winneymj/nrf52832_smartw/nrf.step

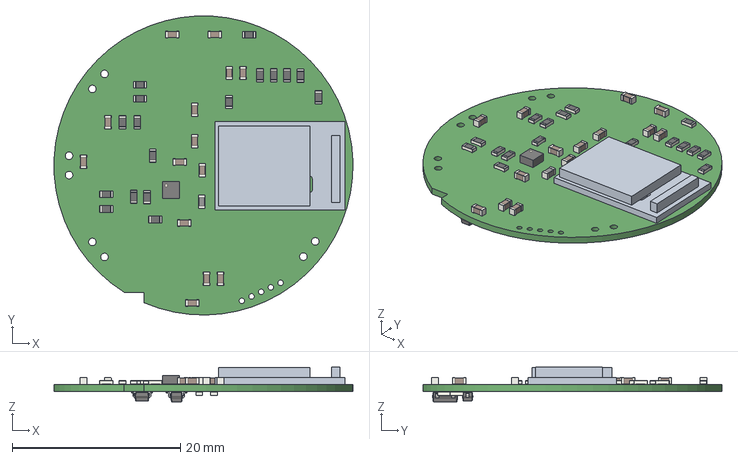
[picture p1: CAD file, 2021-01-30]
nrf.step
35.6 x 35.6 x 4.15 mm
