winneymj/nrf52832_smartw/nrf.kicad_pcb

## KiCad design nrf.kicad_pcb (2021-01-30)

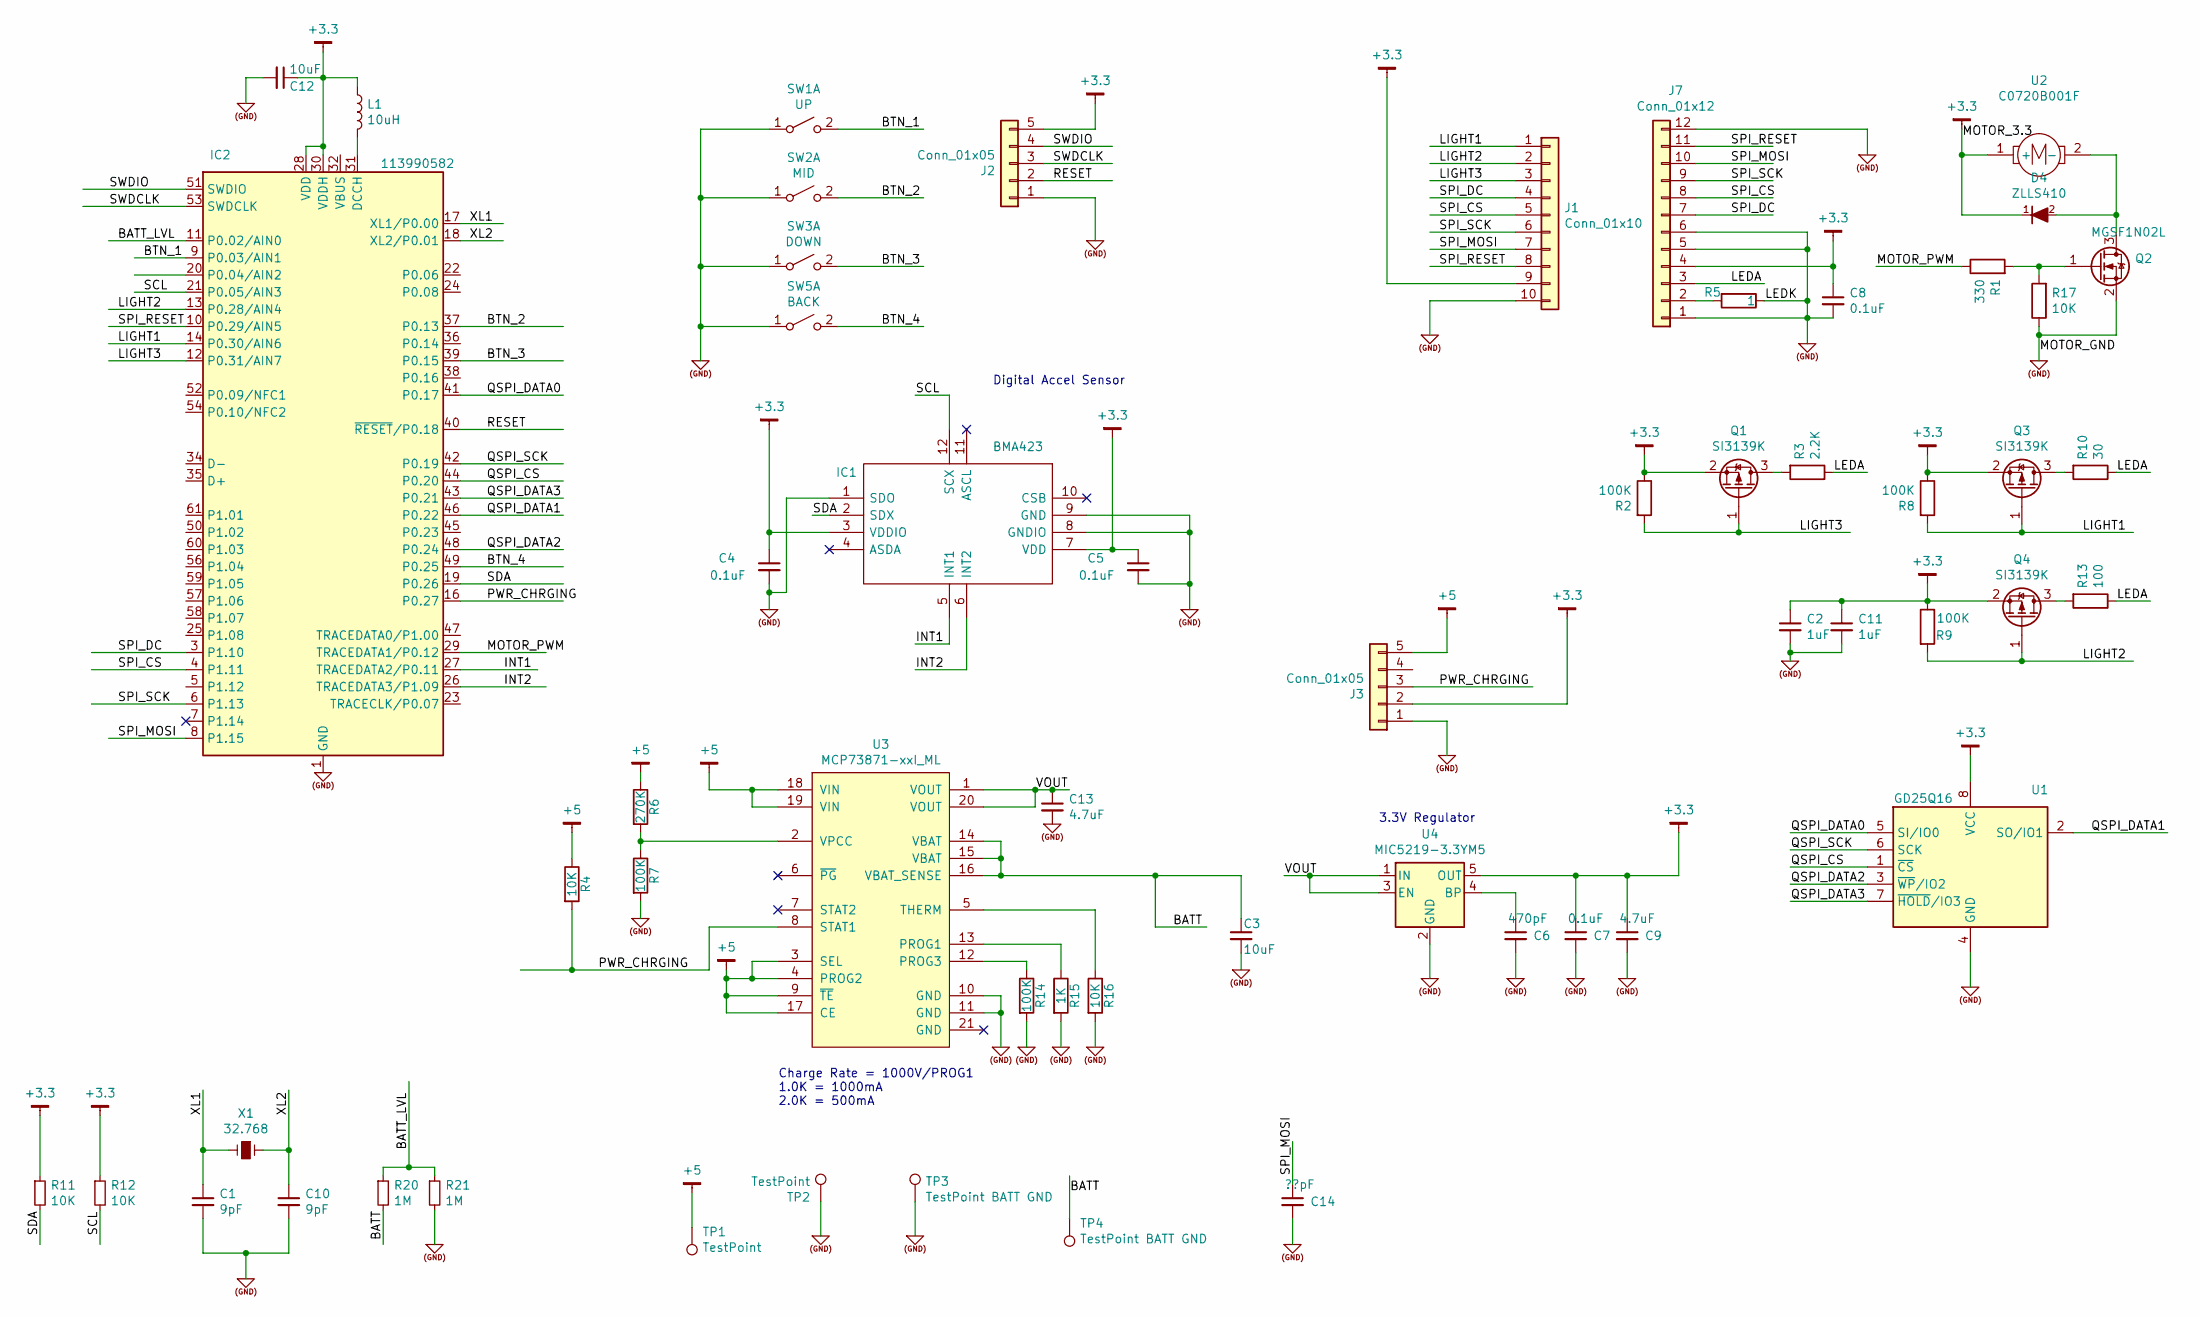
[picture p2: schematic nrf.sch]

Parts:
C1, C10: 9pF; C_0603_1608Metric_Pad1.08x0.95mm_HandSolder
C2, C11: 1uF; C_0603_1608Metric_Pad1.08x0.95mm_HandSolder
C3, C12: 10uF; C_0603_1608Metric_Pad1.08x0.95mm_HandSolder
C4, C5, C7, C8: 0.1uF; C_0603_1608Metric_Pad1.08x0.95mm_HandSolder
C6: 470pF; C_0603_1608Metric_Pad1.08x0.95mm_HandSolder
C9, C13: 4.7uF; C_0603_1608Metric_Pad1.08x0.95mm_HandSolder
C14: ??pF; C_0603_1608Metric_Pad1.08x0.95mm_HandSolder
D4: ZLLS410; D_SOD-323_HandSoldering
IC1: BMA423; LGA-12_2x2mm_P0.5mm_small_pad; Mouser Part Number 262-BMA423
IC2: 113990582; Raytac_MDBT50Q; Mouser Part Number 713-113990582
J1: Conn_01x10; Pin_Header_Straight_1x10_Pitch2.54mm
J2: Conn_01x05; Pin_Header_Straight_1x05_Pitch1.27mm
J3: Conn_01x05; Pin_Header_Straight_1x05_Pitch2.54mm
J7: Conn_01x12; FPC_12x0.7mm
L1: 10uH; L_0603_1608Metric_Pad1.05x0.95mm_HandSolder
Q1, Q3, Q4: SI3139K; SOT-723
Q2: MGSF1N02L; SOT-23
R1: 330; R_0603_1608Metric_Pad0.98x0.95mm_HandSolder
R2, R7, R8, R9, R14: 100K; R_0603_1608Metric_Pad0.98x0.95mm_HandSolder
R3: 2.2K; R_0603_1608Metric_Pad0.98x0.95mm_HandSolder
R4, R11, R12, R16, R17: 10K; R_0603_1608Metric_Pad0.98x0.95mm_HandSolder
R5: 1; R_0603_1608Metric_Pad0.98x0.95mm_HandSolder
R6: 270K; R_0603_1608Metric_Pad0.98x0.95mm_HandSolder
R10: 30; R_0603_1608Metric_Pad0.98x0.95mm_HandSolder
R13: 100; R_0603_1608Metric_Pad0.98x0.95mm_HandSolder
R15: 1K; R_0603_1608Metric_Pad0.98x0.95mm_HandSolder
R20, R21: 1M; R_0603_1608Metric_Pad0.98x0.95mm_HandSolder
SW1: UP; Tact_SW_3x6x3.5
SW2: MID; Tact_SW_3x6x3.5
SW3: DOWN; Tact_SW_3x6x3.5
SW5: BACK; Tact_SW_3x6x3.5
TP1, TP2: TestPoint; TestPoint_Pad_D1.5mm
TP3, TP4: TestPoint BATT GND; TestPoint_Pad_2.0x2.0mm
U1: GD25Q16; USON8-4x3
U2: C0720B001F; VIBRATION MOTOR COIN 3V FLEX - C0720B001F
U3: MCP73871-xxI_ML; QFN-20-1EP_4x4mm_Pitch0.5mm; MPN MCP73871-{output}I/ML
U4: MIC5219-3.3YM5; SOT-23-5
X1: 32.768; Crystal_SMD_EuroQuartz_EQ161-2pin_3.2x1.5mm_HandSoldering

Connections:
(GND): C1.2, C2.2, C3.2, C4.2, C5.2, C6.2, C7.2, C8.2, C9.2, C10.2, C11.2, C12.2, C13.2, C14.2, IC1.1 (SDO), IC1.8 (GNDIO), IC1.9 (GND), IC2.1 (GND), IC2.2 (GND), IC2.15 (GND), IC2.33 (GND), IC2.55 (GND), J1.10, J2.1, J3.1, J7.1, J7.5, J7.6, J7.12, Q2.2 (S), R5.1, R7.2, R14.2, R15.2, R16.2, R17.1, R21.2, SW1.1 (A), SW2.1 (A), SW3.1 (A), SW5.1 (A), TP2.1, TP3.1, U1.4 (GND), U3.10 (GND), U3.11 (GND), U4.2 (GND)
+3.3: C2.1, C4.1, C5.1, C7.1, C8.1, C9.1, C11.1, C12.1, D4.1 (K), IC1.3 (VDDIO), IC1.7 (VDD), IC2.28 (VDD), IC2.30 (VDDH), J1.9, J2.5, J3.2, J7.4, L1.1, Q1.2 (S), Q3.2 (S), Q4.2 (S), R2.1, R8.1, R9.1, R11.1, R12.1, U1.8 (VCC), U2.1 (+), U4.5 (OUT)
+5: J3.5, R4.1, R6.1, TP1.1, U3.3 (SEL), U3.4 (PROG2), U3.9 (~TE), U3.17 (CE), U3.18 (VIN), U3.19 (VIN)
/BATT: C3.1, R20.2, TP4.1, U3.14 (VBAT), U3.15 (VBAT), U3.16 (VBAT_SENSE)
/BATT_LVL: IC2.11 (P0.02/AIN0), R20.1, R21.1
/BTN_1: IC2.9 (P0.03/AIN1), SW1.2 (B)
/BTN_2: IC2.37 (P0.13), SW2.2 (B)
/BTN_3: IC2.39 (P0.15), SW3.2 (B)
/BTN_4: IC2.49 (P0.25), SW5.2 (B)
/INT1: IC1.5 (INT1), IC2.27 (TRACEDATA2/P0.11)
/INT2: IC1.6 (INT2), IC2.26 (TRACEDATA3/P1.09)
/LEDA: J7.3, R3.1, R10.1, R13.1
/LIGHT1: IC2.14 (P0.30/AIN6), J1.1, Q3.1 (G), R8.2
/LIGHT2: IC2.13 (P0.28/AIN4), J1.2, Q4.1 (G), R9.2
/LIGHT3: IC2.12 (P0.31/AIN7), J1.3, Q1.1 (G), R2.2
/MOTOR_PWM: IC2.29 (TRACEDATA1/P0.12), R1.1
/PWR_CHRGING: IC2.16 (P0.27), J3.3, R4.2, U3.8 (STAT1)
/QSPI_CS: IC2.44 (P0.20), U1.1 (~CS)
/QSPI_DATA0: IC2.41 (P0.17), U1.5 (SI/IO0)
/QSPI_DATA1: IC2.46 (P0.22), U1.2 (SO/IO1)
/QSPI_DATA2: IC2.48 (P0.24), U1.3 (~WP~/IO2)
/QSPI_DATA3: IC2.43 (P0.21), U1.7 (~HOLD~/IO3)
/QSPI_SCK: IC2.42 (P0.19), U1.6 (SCK)
/RESET: IC2.40 (~RESET~/P0.18), J2.2
/SCL: IC1.12 (SCX), IC2.21 (P0.05/AIN3), R12.2
/SDA: IC1.2 (SDX), IC2.19 (P0.26), R11.2
/SPI_CS: IC2.4 (P1.11), J1.5, J7.8
/SPI_DC: IC2.3 (P1.10), J1.4, J7.7
/SPI_MOSI: C14.1, IC2.8 (P1.15), J1.7, J7.10
/SPI_RESET: IC2.10 (P0.29/AIN5), J1.8, J7.11
/SPI_SCK: IC2.6 (P1.13), J1.6, J7.9
/SWDCLK: IC2.53 (SWDCLK), J2.3
/SWDIO: IC2.51 (SWDIO), J2.4
/VOUT: C13.1, U3.1 (VOUT), U3.20 (VOUT), U4.1 (IN), U4.3 (EN)
/XL1: C1.1, IC2.17 (XL1/P0.00), X1.2
/XL2: C10.1, IC2.18 (XL2/P0.01), X1.1
unnamed: C6.1, U4.4 (BP)
unnamed: D4.2 (A), Q2.3 (D), U2.2 (-)
unnamed: IC2.31 (DCCH), L1.2
unnamed: J7.2, R5.2
unnamed: Q1.3 (D), R3.2
unnamed: Q2.1 (G), R1.2, R17.2
unnamed: Q3.3 (D), R10.2
unnamed: Q4.3 (D), R13.2
unnamed: R6.2, R7.1, U3.2 (VPCC)
unnamed: R14.1, U3.12 (PROG3)
unnamed: R15.1, U3.13 (PROG1)
unnamed: R16.1, U3.5 (THERM)

Notes on the sheet:
Charge Rate = 1000V/PROG1 1.0K = 1000mA 2.0K = 500mA
3.3V Regulator
Digital Accel Sensor

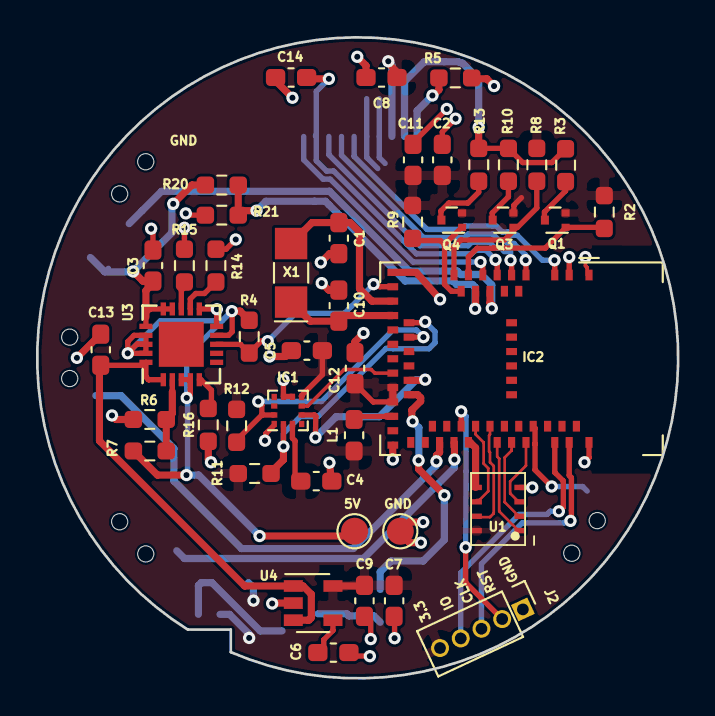
[picture p3: board nrf.kicad_pcb from above]

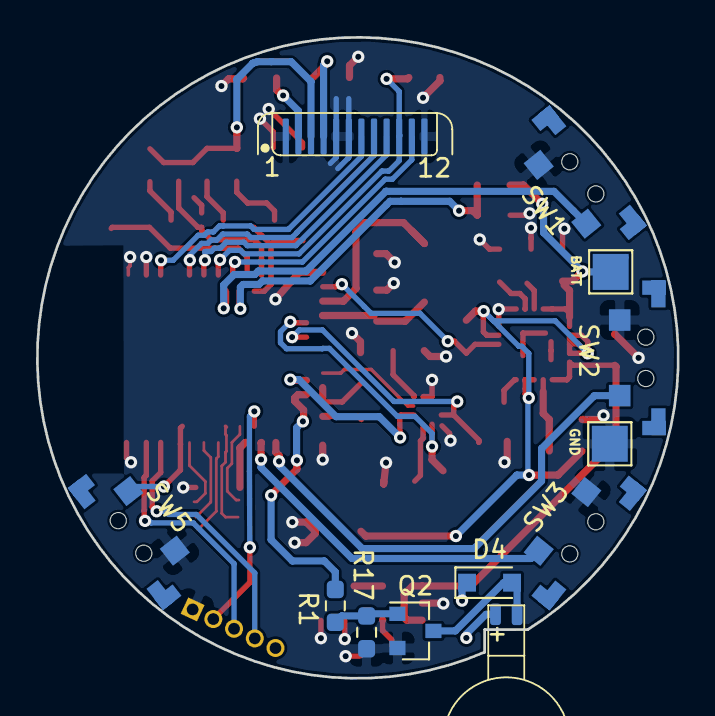
[picture p4: board nrf.kicad_pcb from below]

Board: 2 copper layers, 35.6 x 35.6 mm, 56 parts (12 on the bottom side), 48 nets.
