winneymj/nrf52832_smartw/240x240_display.kicad_pcb

## KiCad design 240x240_display.kicad_pcb (2020-10-25)

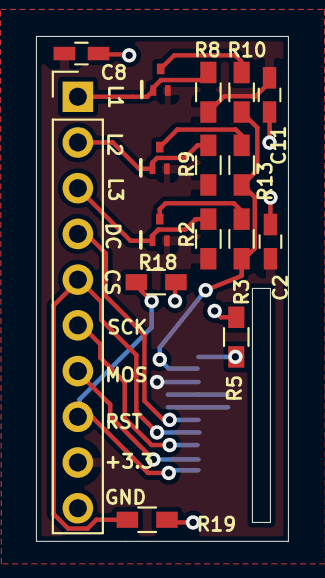
[picture p5: board 240x240_display.kicad_pcb from above]

Board: 2 copper layers, 14.0 x 28.0 mm, 17 parts (1 on the bottom side), 15 nets.

Parts:
C2, C11: 1uF; C_0603_HandSoldering
C8: 0.1uF; C_0603_HandSoldering
J1: Conn_01x10; Pin_Header_Straight_1x10_Pitch2.54mm
J7: Conn_01x12; FPC_12x0.7mm
Q1, Q3, Q4: SI3139K; SOT-723_Handsoldering
R2, R8, R9: 100K; R_0603_HandSoldering
R3: 2.2K; R_0603_HandSoldering
R5: 1; R_0603_HandSoldering
R10: 30; R_0603_HandSoldering
R13: 100; R_0603_HandSoldering
R18, R19: 10K; R_0603_HandSoldering

Connections:
(GND): C2.2, C8.2, C11.2, J1.10, J7.1, J7.5, J7.6, J7.12, R5.1, R18.2, R19.2
+3.3: C2.1, C8.1, C11.1, J1.9, J7.4, Q1.2, Q3.2, Q4.2, R2.1, R8.1, R9.1
/LEDA: J7.3, R3.1, R10.1, R13.1
/LIGHT1: J1.1, Q3.1, R8.2
/LIGHT2: J1.2, Q4.1, R9.2
/LIGHT3: J1.3, Q1.1, R2.2
/SPI_CS: J1.5, J7.8, R19.1
/SPI_DC: J1.4, J7.7
/SPI_MOSI: J1.7, J7.10
/SPI_RESET: J1.8, J7.11, R18.1
/SPI_SCK: J1.6, J7.9
unnamed: J7.2, R5.2
unnamed: Q1.3, R3.2
unnamed: Q3.3, R10.2
unnamed: Q4.3, R13.2
