winneymj/nrf52832_smartw/vibration_motor.kicad_pcb

## KiCad design vibration_motor.kicad_pcb (2019-08-04)

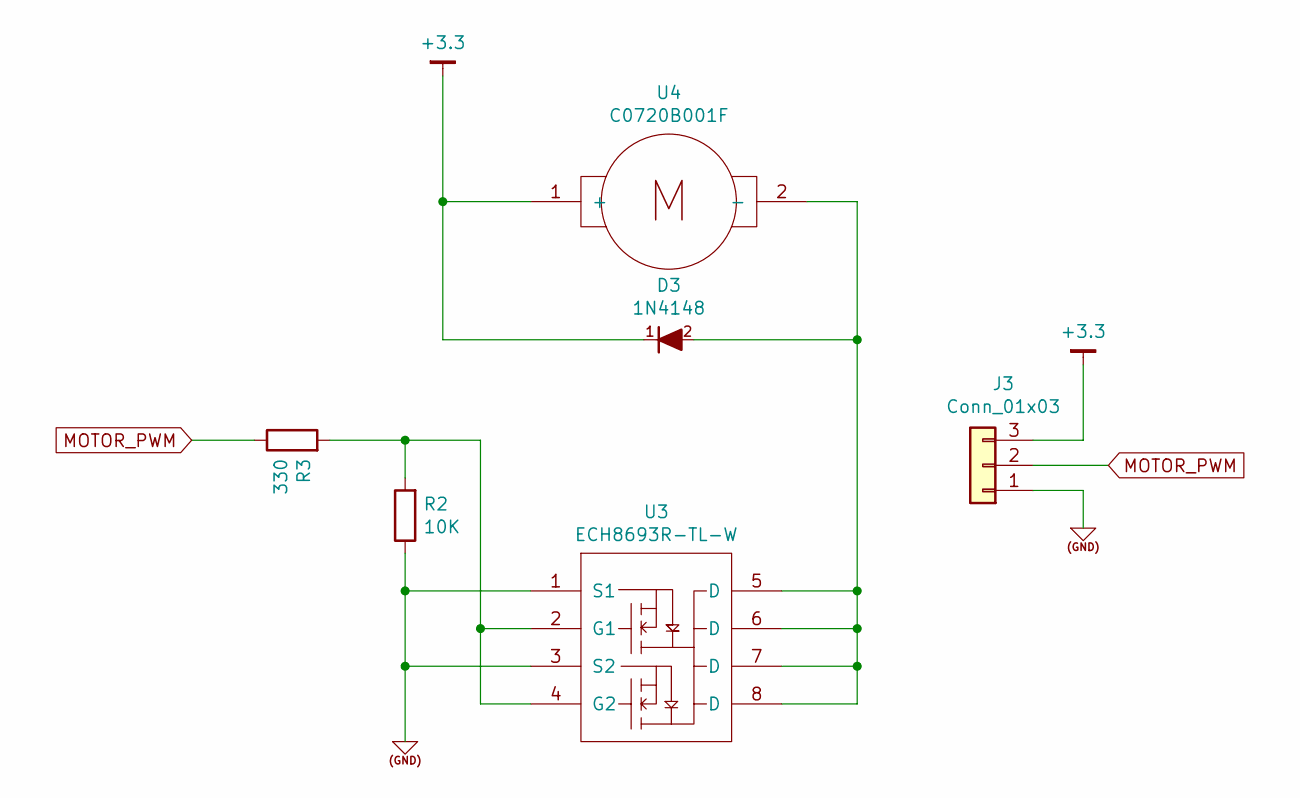
[picture p6: schematic vibration_motor.sch]

Parts:
D3: 1N4148; D_SOD-123
J3: Conn_01x03; Pin_Header_Straight_1x03_Pitch2.54mm
R2: 10K; R_0805
R3: 330; R_0805
U3: ECH8693R-TL-W; SOT-28FL
U4: C0720B001F; VIBRATION MOTOR COIN 3V FLEX - C0720B001F

Connections:
(GND): J3.1, R2.1, U3.1 (S1), U3.3 (S2)
+3.3: D3.1 (K), J3.3, U4.1 (+)
MOTOR_PWM: J3.2, R3.1
unnamed: D3.2 (A), U3.5 (D), U3.6 (D), U3.7 (D), U3.8 (D), U4.2 (-)
unnamed: R2.2, R3.2, U3.2 (G1), U3.4 (G2)

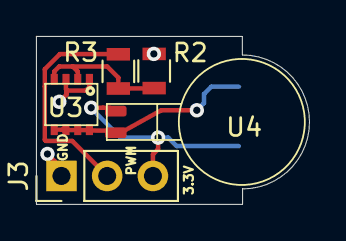
[picture p7: board vibration_motor.kicad_pcb from above]

Board: 2 copper layers, 15.2 x 9.3 mm, 6 parts (1 on the bottom side), 5 nets.
