winneymj/nrf52832_smartw/accell.kicad_pcb

## KiCad design accell.kicad_pcb (2021-01-30)

Schematic: accelerometer.sch

Parts:
C4, C5: 100nF; C_0603_HandSoldering
IC1: BMA423; Mouser Part Number 262-BMA423
J4: Conn_01x06; Pin_Header_Straight_1x06_Pitch2.54mm
R11, R12: 10K; R_0603_HandSoldering

Connections:
(GND): C4.2, C5.2, IC1.1 (SDO), IC1.8 (GNDIO), IC1.9 (GND), J4.6
+3.3: C4.1, C5.1, IC1.3 (VDDIO), IC1.7 (VDD), J4.1, R11.1, R12.1
I2C_SCL: IC1.12 (SCX), J4.3, R11.2
I2C_SDA: IC1.2 (SDX), J4.2, R12.2
XL_INT_1: IC1.5 (INT1), J4.4
XL_INT_2: IC1.6 (INT2), J4.5

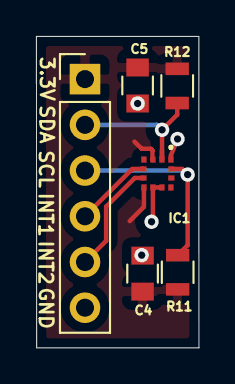
[picture p8: board accell.kicad_pcb from above]

Board: 2 copper layers, 9.0 x 17.3 mm, 6 parts (0 on the bottom side), 6 nets.
