winneymj/nrf52832_smartw/vibr.kicad_pcb

## KiCad design vibr.kicad_pcb (2019-07-04)

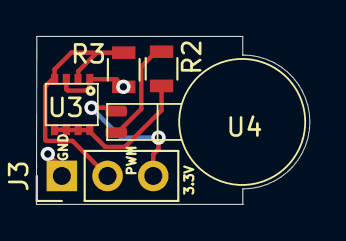
[picture p9: board vibr.kicad_pcb from above]

Board: 2 copper layers, 15.2 x 9.3 mm, 5 parts (0 on the bottom side), 5 nets.

Parts:
J3: Conn_01x03; Pin_Header_Straight_1x03_Pitch2.54mm
R2: 10K; R_0805
R3: 330; R_0805
U3: ECH8693R-TL-W; SOT-28FL
U4: C0720B001F; VIBRATION MOTOR COIN 3V FLEX - C0720B001F

Connections:
(GND): J3.1, R2.1, U3.1, U3.3
+3.3: J3.3, U4.1
MOTOR_PWM: J3.2, R2.2, U3.2, U3.4
unnamed: R3.1, U3.5, U3.6, U3.7, U3.8
unnamed: R3.2, U4.2
