winneymj/nrf52832_smartw/(commit log)

2019-06-20 More power setup
    [accelerometer.sch, nrf.kicad_pcb, nrf.sch, pwr.sch]
2019-06-23 Layout power
    [nrf.kicad_pcb]
2019-06-24 More power connections
    [nrf.kicad_pcb]
2019-06-25 More PCB setup
    [accelerometer.sch, nrf.kicad_pcb, nrf.sch, pwr.sch, vibration_motor.sch]
2019-07-03 New PCB's
    [accell.kicad_pcb, nrf.sch, vibr.kicad_pcb, vibration_motor.sch]
2019-08-04 Rework and rename parts
    [vibration_motor.kicad_pcb, vibration_motor.sch]
2019-10-05 New Power_Management from Pin64 schematic. Much less parts
    [accell.kicad_pcb, pwr.sch, vibration_motor.sch]
2019-10-14 Implement 240x240 IPS display
    [240x240_display.kicad_pcb, 240x240_display.sch, accelerometer.sch, nrf.sch, pwr.sch, vibration_motor.sch]
2019-10-16 Power board PCB
    [240x240_display.sch, power.kicad_pcb, pwr.sch, vibration_motor.sch]
2019-10-17 Build power board
    [240x240_display.sch, power.kicad_pcb, pwr.sch]
2019-10-18 More power board layout
    [power.kicad_pcb]
2019-10-20 v.01 power board PCB
    [power.kicad_pcb, pwr.sch]
2019-10-27 Circular Display
    [240x240_display.sch, accelerometer.sch, display.kicad_pcb, display.sch, nrf.sch, pwr.sch, vibration_motor.sch]
2019-10-28 update for display footprint
    [240x240_display.kicad_pcb, 240x240_display.sch, accelerometer.sch, nrf.sch, pwr.sch, vibration_motor.sch]
2019-11-05 update for power footprint
    [240x240_display.kicad_pcb, power.kicad_pcb, pwr.sch]
2020-05-12 see what happens
    [nrf.sch]
2020-05-14 Update for accel
    [nrf.kicad_pcb, nrf.sch, pwr.sch]
2020-05-17 Move power from sub sheet
    [nrf.kicad_pcb, nrf.sch]
2020-05-18 Layout board
    [nrf.kicad_pcb, nrf.sch]
2020-10-25 More layout changes
    [240x240_display.kicad_pcb, display.kicad_pcb, nrf.kicad_pcb, nrf.sch, power.csv, power.kicad_pcb]
2020-11-01 Board Update
    [nrf.kicad_pcb, nrf.sch]
2020-11-03 Change resistors to 0603 imperial
    [nrf.kicad_pcb, nrf.sch]
2020-11-25 Update footprints
    [accell.kicad_pcb, nrf.kicad_pcb, nrf.sch]
2020-11-30 Update GND connections from under pads
    [nrf.kicad_pcb, nrf.step]
2021-01-30 Board updates
    [accell.kicad_pcb, nrf.kicad_pcb, nrf.sch, nrf.step]
